Taller-de-sistemas-embebidos-tps/tdse-tf_2-01/Memoria_del_Trabajo_Final_Sleep_Centinel/img/diagrama_de_bloques.png

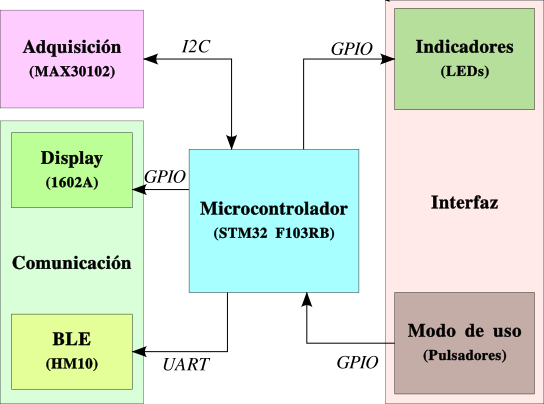
Memoria_del_Trabajo_Final_Sleep_Centinel/img/diagrama_de_bloques.png
