Taller-de-sistemas-embebidos-tps/tdse-tf_2-01/Memoria_del_Trabajo_Final_Sleep_Centinel/img/maqestadosystem.jpeg

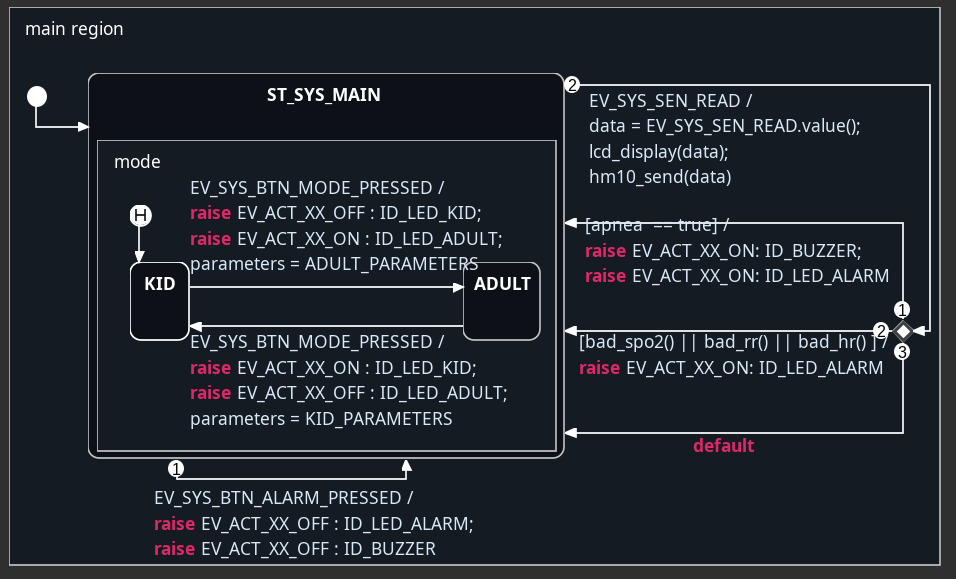
Memoria_del_Trabajo_Final_Sleep_Centinel/img/maqestadosystem.jpeg
