Taller-de-sistemas-embebidos-tps/tdse-tf_2-01/kicad/models/Part_04_varible_resister.stp

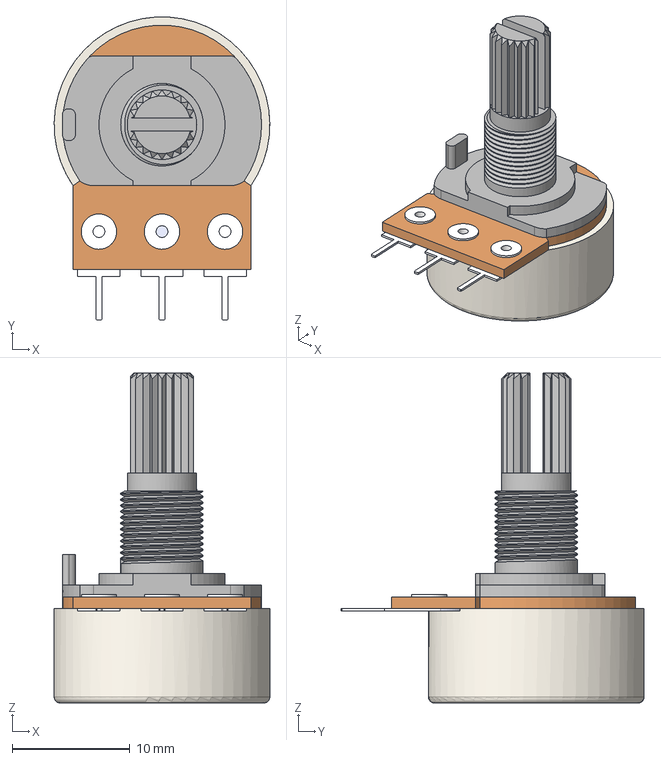
[picture p36: CAD file, 2026-03-10]
kicad/models/Part_04_varible_resister.stp
18.3 x 25.7 x 28.0 mm
