Taller-de-sistemas-embebidos-tps/tdse-tf_2-01/TODO.md

##
Una lista de puequeños TODOs para organizar el desarrollo
- [ ] Optimizar uso de format_string para que solo actualice los valores en lugar de todo el texto
- [ ] Formatear los datos a enviar por bluetooth
- [ ] Eliminar comentarios en el codigo
- [ ] Agregar lógica de transicion de finger in o out en task_sensor
