Taller-de-sistemas-embebidos-tps/tdse-tf_2-01/kicad/schematic.pdf

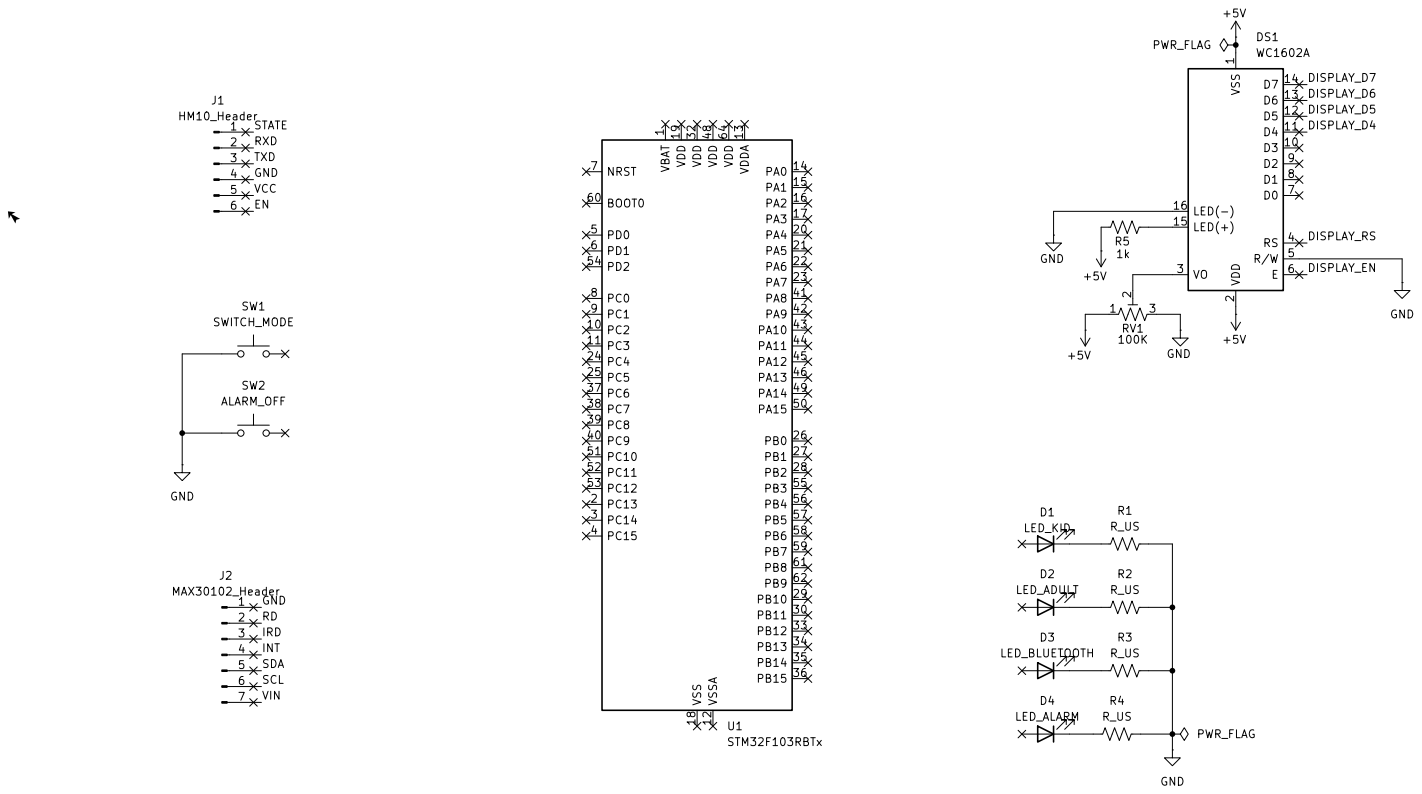
[picture p37: page 1]
