Taller-de-sistemas-embebidos-tps/tdse-tf_2-01/kicad/tp.kicad_pcb

## KiCad design kicad/tp.kicad_pcb (2026-03-10)

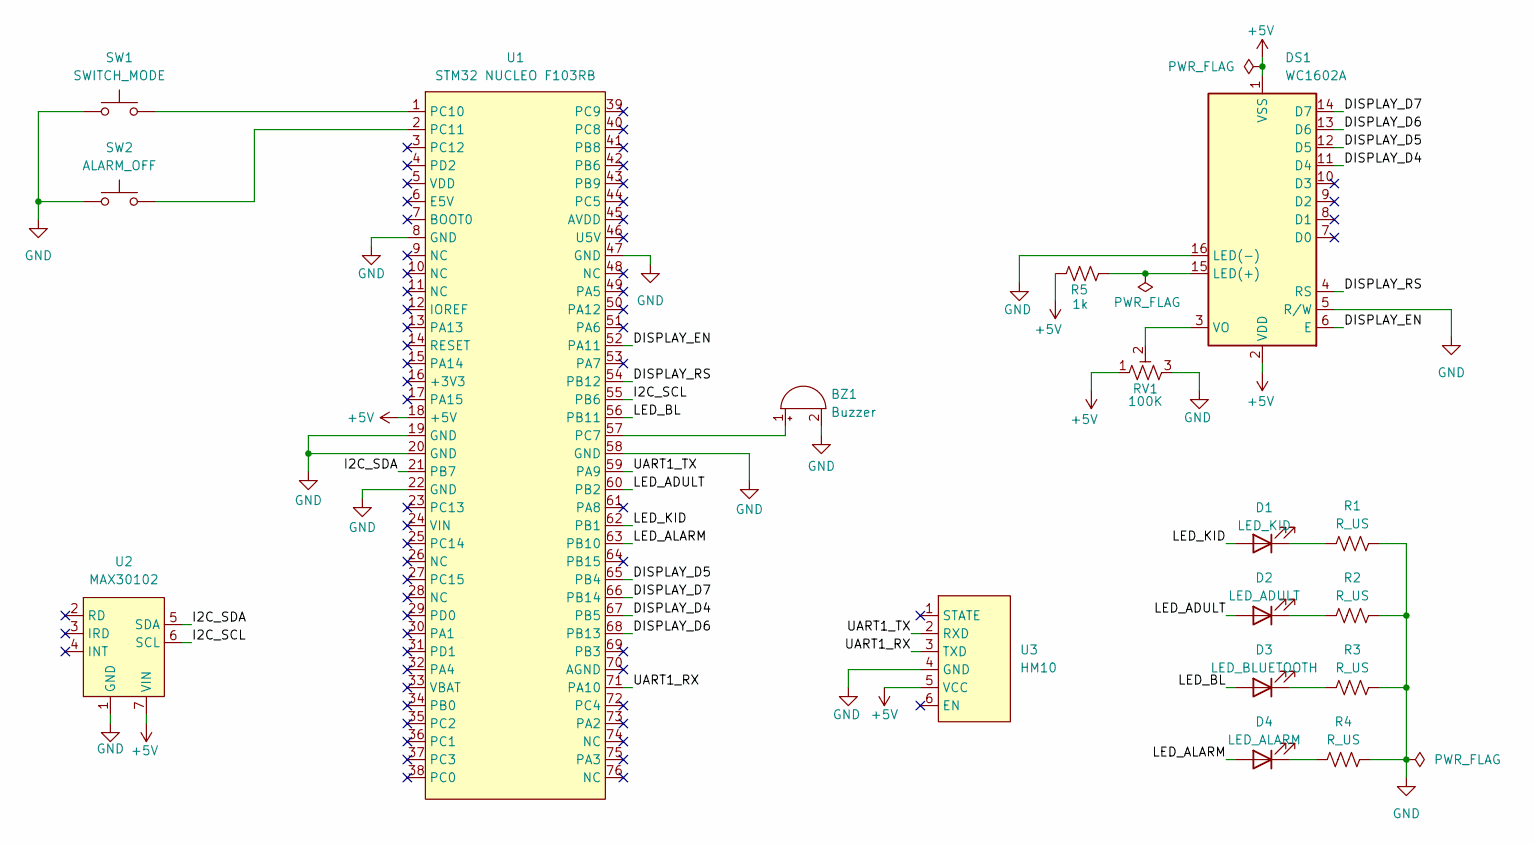
[picture p38: schematic tp.kicad_sch]

Parts:
BZ1: Buzzer; Buzzer_12x9.5RM7.6
D1: LED_KID; LED_D5.0mm
D2: LED_ADULT; LED_D5.0mm
D3: LED_BLUETOOTH; LED_D5.0mm
D4: LED_ALARM; LED_D5.0mm
DS1: WC1602A
R1, R2, R3, R4: R_US; R_Axial_DIN0207_L6.3mm_D2.5mm_P7.62mm_Horizontal
R5: 1k; R_Axial_DIN0207_L6.3mm_D2.5mm_P7.62mm_Horizontal
RV1: 100K; Potentiometer_Alps_RK163_Single_Horizontal
SW1: SWITCH_MODE; SW_PUSH-12mm_Wuerth-430476085716
SW2: ALARM_OFF; SW_PUSH-12mm_Wuerth-430476085716
U1: STM32 NUCLEO F103RB; NUCLEO F103RB
U2: MAX30102; PinSocket_1x07_P2.54mm_Vertical
U3: HM10; PinSocket_1x06_P2.54mm_Vertical

Connections:
+5V: DS1.1 (VSS), DS1.2 (VDD), R5.2, RV1.1, U1.18 (+5V), U2.7 (VIN), U3.5 (VCC)
/DISPLAY_D4: DS1.11 (D4), U1.67 (PB5)
/DISPLAY_D5: DS1.12 (D5), U1.65 (PB4)
/DISPLAY_D6: DS1.13 (D6), U1.68 (PB13)
/DISPLAY_D7: DS1.14 (D7), U1.66 (PB14)
/DISPLAY_EN: DS1.6 (E), U1.52 (PA11)
/DISPLAY_RS: DS1.4 (RS), U1.54 (PB12)
/I2C_SCL: U1.55 (PB6), U2.6 (SCL)
/I2C_SDA: U1.21 (PB7), U2.5 (SDA)
/LED_ADULT: D2.2 (A), U1.60 (PB2)
/LED_ALARM: D4.2 (A), U1.63 (PB10)
/LED_BL: D3.2 (A), U1.56 (PB11)
/LED_KID: D1.2 (A), U1.62 (PB1)
/UART1_RX: U1.71 (PA10), U3.3 (TXD)
/UART1_TX: U1.59 (PA9), U3.2 (RXD)
GND: BZ1.2 (-), DS1.5 (R/W), DS1.16 (LED(-)), R1.2, R2.2, R3.2, R4.2, RV1.3, SW1.1, SW2.1, U1.8 (GND), U1.19 (GND), U1.20 (GND), U1.22 (GND), U1.47 (GND), U1.58 (GND), U2.1 (GND), U3.4 (GND)
unnamed: BZ1.1 (+), U1.57 (PC7)
unnamed: D1.1 (K), R1.1
unnamed: D2.1 (K), R2.1
unnamed: D3.1 (K), R3.1
unnamed: D4.1 (K), R4.1
unnamed: DS1.15 (LED(+)), R5.1
unnamed: DS1.3 (VO), RV1.2
unnamed: SW1.2, U1.1 (PC10)
unnamed: SW2.2, U1.2 (PC11)

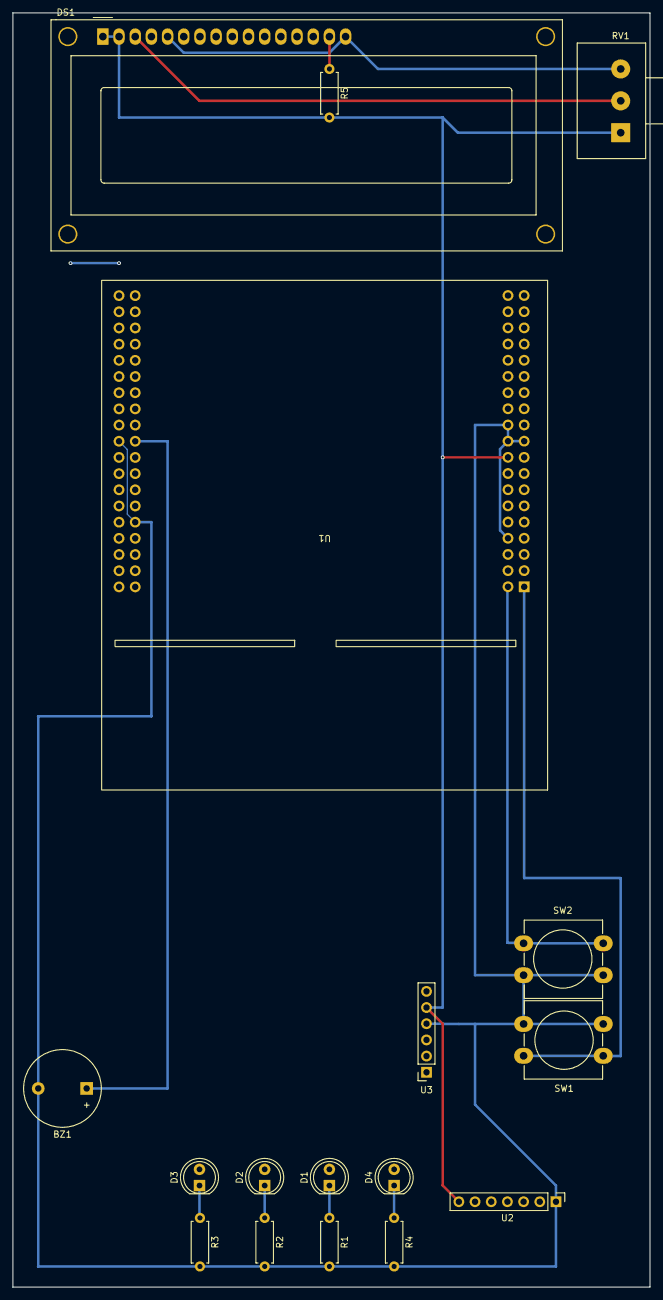
[picture p39: board tp.kicad_pcb from above]

Board: 10 copper layers, 100.0 x 200.0 mm, 17 parts (0 on the bottom side), 25 nets.
