Taller-de-sistemas-embebidos-tps/tdse-tf_2-01/code_final/Core/Inc/main.h

#define B1_Pin GPIO_PIN_13
#define B1_GPIO_Port GPIOC
#define B1_EXTI_IRQn EXTI15_10_IRQn
#define USART_TX_Pin GPIO_PIN_2
#define USART_TX_GPIO_Port GPIOA
#define USART_RX_Pin GPIO_PIN_3
#define USART_RX_GPIO_Port GPIOA
#define LD2_Pin GPIO_PIN_5
#define LD2_GPIO_Port GPIOA
#define LED_KID_Pin GPIO_PIN_1
#define LED_KID_GPIO_Port GPIOB
#define LED_ADULT_Pin GPIO_PIN_2
#define LED_ADULT_GPIO_Port GPIOB
#define LED_ALARM_Pin GPIO_PIN_10
#define LED_ALARM_GPIO_Port GPIOB
#define LED_BL_Pin GPIO_PIN_11
#define LED_BL_GPIO_Port GPIOB
#define DISPLAY_RS_Pin GPIO_PIN_12
#define DISPLAY_RS_GPIO_Port GPIOB
#define DISPLAY_D6_Pin GPIO_PIN_13
#define DISPLAY_D6_GPIO_Port GPIOB
#define DISPLAY_D7_Pin GPIO_PIN_14
#define DISPLAY_D7_GPIO_Port GPIOB
#define BUZZER_Pin GPIO_PIN_7
#define BUZZER_GPIO_Port GPIOC
#define DISPLAY_EN_Pin GPIO_PIN_11
#define DISPLAY_EN_GPIO_Port GPIOA
#define TMS_Pin GPIO_PIN_13
#define TMS_GPIO_Port GPIOA
#define TCK_Pin GPIO_PIN_14
#define TCK_GPIO_Port GPIOA
#define BTN_MODE_Pin GPIO_PIN_10
#define BTN_MODE_GPIO_Port GPIOC
#define BTN_ALARM_Pin GPIO_PIN_11
#define BTN_ALARM_GPIO_Port GPIOC
#define BTN_PAIRING_Pin GPIO_PIN_12
#define BTN_PAIRING_GPIO_Port GPIOC
#define SWO_Pin GPIO_PIN_3
#define SWO_GPIO_Port GPIOB
#define DISPLAY_D5_Pin GPIO_PIN_4
#define DISPLAY_D5_GPIO_Port GPIOB
#define DISPLAY_D4_Pin GPIO_PIN_5
#define DISPLAY_D4_GPIO_Port GPIOB
