Taller-de-sistemas-embebidos-tps/tdse-tf_2-01/code_final/app/src/task_system.c

/*
 * Copyright (c) 2023 Juan Manuel Cruz <jcruz@fi.uba.ar> <jcruz@frba.utn.edu.ar>.
 * All rights reserved.
 *
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
 * 1. Redistributions of source code must retain the above copyright
 *    notice, this list of conditions and the following disclaimer.
 *
 * 2. Redistributions in binary form must reproduce the above copyright
 *    notice, this list of conditions and the following disclaimer in the
 *    documentation and/or other materials provided with the distribution.
 *
 * 3. Neither the name of the copyright holder nor the names of its
 *    contributors may be used to endorse or promote products derived from
 *    this software without specific prior written permission.
 *
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
 * @file   : task_system.c
 * @date   : Set 26, 2023
 * @author : Juan Manuel Cruz <jcruz@fi.uba.ar> <jcruz@frba.utn.edu.ar>
 * @version	v1.0.0
 */

/********************** inclusions *******************************************/
/* Project includes */
#include "main.h"

/* Demo includes */
#include "logger.h"
#include "dwt.h"

/* Application & Tasks includes */
#include "board.h"
#include "app.h"
#include "task_system_attribute.h"
#include "task_system_interface.h"
#include "task_actuator_attribute.h"
#include "task_actuator_interface.h"
#include "display.h"
#include "comm.h"

extern UART_HandleTypeDef huart2;

/********************** macros and definitions *******************************/
#define G_TASK_SYS_CNT_INI			0ul
#define G_TASK_SYS_TICK_CNT_INI		0ul

#define DEL_SYS_MIN					0ul
#define DEL_SYS_MED					25ul
#define DEL_SYS_MAX					50ul

#define SPO2_LOW				86

#define HR_LOW_KID_THRESHOLD	90
#define HR_HIGH_KID_THRESHOLD	120
#define RR_LOW_KID_THRESHOLD	15
#define RR_HIGH_KID_THRESHOLD	30

#define HR_LOW_ADULT_THRESHOLD	45
#define HR_HIGH_ADULT_THRESHOLD	90
#define RR_LOW_ADULT_THRESHOLD	10
#define RR_HIGH_ADULT_THRESHOLD	20

/********************** internal data declaration ****************************/
const parameters_t kid_parameters  = {
	.spo2 = SPO2_LOW,
	.min_hr = HR_LOW_KID_THRESHOLD,
	.max_hr = HR_HIGH_KID_THRESHOLD,
	.min_rr = RR_LOW_KID_THRESHOLD,
	.max_rr = RR_HIGH_KID_THRESHOLD,
};

const parameters_t adult_parameters = {
	.spo2 = SPO2_LOW,
	.min_hr = HR_LOW_ADULT_THRESHOLD,
	.max_hr = HR_HIGH_ADULT_THRESHOLD,
	.min_rr = RR_LOW_ADULT_THRESHOLD,
	.max_rr = RR_HIGH_ADULT_THRESHOLD,
};

task_system_dta_t task_system_dta =	{
	.state = ST_SYS_MAIN,
	.event = EV_SYS_BTN_PAIRING_PRESSED,
	.mode = ID_KID,
	.tick = DEL_SYS_MAX,
	.parameters = kid_parameters
};

/********************** internal functions declaration ***********************/
void task_system_statechart(void);

void format_to_lcd_string(char out[2][17], task_sensor_results_dta_t data);

void print_to_lcd(char formatted_data[2][17]);

/********************** internal data definition *****************************/
const char *p_task_system 		= "Task System (System Statechart)";
const char *p_task_system_ 		= "Non-Blocking & Update By Time Code";

/********************** external data declaration ****************************/
uint32_t g_task_system_cnt;
volatile uint32_t g_task_system_tick_cnt;

/********************** external functions definition ************************/
void task_system_init(void *parameters)
{
	task_system_dta_t 	*p_task_system_dta;
	task_system_st_t	state;

	/* Print out: Task Initialized */
	//LOGGER_INFO(" ");
	//LOGGER_INFO("  %s is running - %s", GET_NAME(task_system_init), p_task_system);
	//LOGGER_INFO("  %s is a %s", GET_NAME(task_system), p_task_system_);

	/* Init & Print out: Task execution counter */
	g_task_system_cnt = G_TASK_SYS_CNT_INI;
	//LOGGER_INFO("   %s = %lu", GET_NAME(g_task_system_cnt), g_task_system_cnt);

	init_queue_event_task_system();

	/* Update Task Actuator Configuration & Data Pointer */
	p_task_system_dta = &task_system_dta;

	/* Init & Print out: Task execution FSM */
	state = ST_SYS_MAIN;
	p_task_system_dta->state = state;

	//LOGGER_INFO(" ");
	//LOGGER_INFO("   %s = %lu   %s = %lu   %s = %s",
	//			 GET_NAME(state), (uint32_t)state,
	//			 GET_NAME(event), (uint32_t)event,
	//			 GET_NAME(b_event), (b_event ? "true" : "false"));

	displayInit( DISPLAY_CONNECTION_GPIO_4BITS );

    displayCharPositionWrite(0, 0);
	displayStringWrite("Sleep Centinel");

	hm10_init(&huart2);
}

void task_system_update(void *parameters)
{
	bool b_time_update_required = false;

	/* Protect shared resource */
	__asm("CPSID i");	/* disable interrupts */
    if (G_TASK_SYS_TICK_CNT_INI < g_task_system_tick_cnt)
    {
		/* Update Tick Counter */
    	g_task_system_tick_cnt--;
    	b_time_update_required = true;
    }
    __asm("CPSIE i");	/* enable interrupts */

    while (b_time_update_required)
    {
		/* Update Task Counter */
		g_task_system_cnt++;

		/* Run Task Statechart */
    	task_system_statechart();

    	/* Protect shared resource */
		__asm("CPSID i");	/* disable interrupts */
		if (G_TASK_SYS_TICK_CNT_INI < g_task_system_tick_cnt)
		{
			/* Update Tick Counter */
			g_task_system_tick_cnt--;
			b_time_update_required = true;
		}
		else
		{
			b_time_update_required = false;
		}
		__asm("CPSIE i");	/* enable interrupts */
    }
}

void task_system_statechart(void)
{
	task_system_dta_t *p_task_system_dta;

	p_task_system_dta = &task_system_dta;


	if (true == any_event_task_system())
	{
		p_task_system_dta->event = get_event_task_system();


		switch (p_task_system_dta->state)
		{
			case ST_SYS_MAIN:
				switch (p_task_system_dta->event) {
					case EV_SYS_BTN_MODE_PRESSED:
						//LOGGER_INFO("cambiando de estado");
						if (p_task_system_dta->mode == ID_KID) {
							p_task_system_dta->mode = ID_ADULT;
							p_task_system_dta->parameters = adult_parameters;
							put_event_task_actuator(EV_ACT_OFF, ID_LED_KID);
							put_event_task_actuator(EV_ACT_ON, ID_LED_ADULT);
							displayCharPositionWrite(0, 1);
							displayStringWrite("           ");
							displayCharPositionWrite(0, 1);
							displayStringWrite("Modo adulto");
						} else {
							p_task_system_dta->mode = ID_KID;
							p_task_system_dta->parameters = kid_parameters;
							put_event_task_actuator(EV_ACT_OFF, ID_LED_ADULT);
							put_event_task_actuator(EV_ACT_ON, ID_LED_KID);
							displayCharPositionWrite(0, 1);
							displayStringWrite("           ");
							displayCharPositionWrite(0, 1);
							displayStringWrite("Modo nino");
						}
						break;

					case EV_SYS_BTN_ALARM_PRESSED:
						put_event_task_actuator(EV_ACT_OFF, ID_LED_ALARM);
						put_event_task_actuator(EV_ACT_OFF, ID_BUZZER);
						//LOGGER_INFO("Apagando la alarma");
						break;

					case EV_SYS_BTN_PAIRING_PRESSED:
						put_event_task_actuator(EV_ACT_BLINK, ID_LED_BLUETOOTH);
						break;

					case EV_SYS_SEN_READ:
						static char lcd_text[2][17];

						task_sensor_results_dta_t result = get_sensor_results();
						format_to_lcd_string(lcd_text, result);
						print_to_lcd(lcd_text);
						hm10_send_data((uint8_t *)lcd_text, 17*2);

						parameters_t params = p_task_system_dta->parameters;
						if (
							result.spo2 < params.spo2 ||
							result.heart_rate < params.min_hr || result.heart_rate > params.max_hr ||
							result.respiratory_rate < params.min_rr || result.respiratory_rate > params.max_rr
						) {
							put_event_task_actuator(EV_ACT_ON, ID_LED_ALARM);
						}

						if (result.apnea == true) {
							put_event_task_actuator(EV_ACT_ON, ID_LED_ALARM);
							put_event_task_actuator(EV_ACT_ON, ID_BUZZER);
						}
						break;

					default:
						break;
				}

				break;

			default:
				p_task_system_dta->state = ST_SYS_MAIN;
				// p_task_system_dta->event = EV_SYS_IDLE;
				break;
		}
	}
}

void format_to_lcd_string(char out[2][17], task_sensor_results_dta_t data)
{
    // Línea 1
    out[0][0] = 'a';
    out[0][1] = 'p';
    out[0][2] = 'n';
    out[0][3] = 'e';
    out[0][4] = 'a';
    out[0][5] = ' ';

    if(data.apnea) {
        out[0][6] = 'S';
        out[0][7] = 'I';
    } else {
        out[0][6] = 'N';
        out[0][7] = 'O';
    }

    out[0][8]  = ' ';
    out[0][9]  = ' ';
    out[0][10] = 'h';
    out[0][11] = 'r';
    out[0][12] = ' ';

    out[0][13] = '0' + (data.heart_rate / 100) % 10;
    out[0][14] = '0' + (data.heart_rate / 10) % 10;
    out[0][15] = '0' + (data.heart_rate % 10);

    out[0][16] = '\0';

    // Línea 2
    out[1][0] = 's';
    out[1][1] = 'p';
    out[1][2] = 'o';
    out[1][3] = '2';
    out[1][4] = ' ';

    out[1][5] = '0' + (data.spo2 / 100) % 10;
    out[1][6] = '0' + (data.spo2 / 10) % 10;
    out[1][7] = '0' + (data.spo2 % 10);

    out[1][8]  = ' ';
    out[1][9]  = ' ';
    out[1][10] = 'r';
    out[1][11] = 'r';
    out[1][12] = ' ';

    out[1][13] = '0' + (data.respiratory_rate / 100) % 10;
    out[1][14] = '0' + (data.respiratory_rate / 10) % 10;
    out[1][15] = '0' + (data.respiratory_rate % 10);

    out[1][16] = '\0';
}

void print_to_lcd(char formatted_data[2][17]) {
	displayCharPositionWrite(0, 0);
	displayStringWrite(formatted_data[0]);
	displayCharPositionWrite(0, 1);
	displayStringWrite(formatted_data[1]);
}

/********************** end of file ******************************************/
