Taller-de-sistemas-embebidos-tps/tdse-tf_2-01/(commit log)

2025-11-14 docs: Agrego periodo de entrega
2025-11-15 Adjunto diagrame de bloques
2025-11-15 docs: Arreglo URL del diagrama de bloques
2025-11-15 docs: Corrijo modelo de placa
2025-11-15 Correcion de imagenes y redaccón
2025-11-19 Limpio el repositorio
2025-11-19 docs: agrego la descripción del proyecto
2026-02-01 feat: agrega codigo base de proyecto
2026-02-02 feat: agrega botones de interaccion
2026-02-02 fix: comento pines no usados y arreglo las cfg de los botones
    [display.c, task_sensor.c]
2026-02-05 Create Informe de avance
2026-02-05 docs: agrega bullet de alimentacion
2026-02-25 feat: agrega pines del display
    [code Debug.cfg]
2026-02-25 feat: descomenta uso de pines para display
2026-02-25 fix: typo y agrega boton de pairing
    [main.c, main.h]
2026-02-25 feat: agrega esqueleto de tarea de comunicacion
2026-02-25 feat(comm): agrega estructuras de cfg y dta pertinentes
2026-02-25 refactor: comenta temporalmente la communicacion
    hasta saber bien como inicializar uart
2026-02-25 feat(actuator): actualiza cfg y dta por modelo real de un led/buzzer
    [task_actuator.c, task_actuator_attribute.h]
2026-02-25 feat: agrega parámetro de futura optimización
2026-02-25 feat: actualiza interfaz para interactuar con el actuador
2026-02-25 feat(button): agrega config pull_up de pines
2026-02-25 feat: agrega version de proyecto funcional
    el otro no corre los ticks y no sabemos por qué
    [code_final.cfg]
2026-02-25 feat(button): cambio de pines a los nuestros
2026-02-25 feat(actuator): agrega pines y attributos
2026-02-26 feat(system): solo ejecuta el statechart si hay eventos
2026-02-26 fix(actuator): agrega parametros de modo
    [task_actuator.c, task_system_attribute.h]
2026-02-26 feat(actuator): agrega blink_funcional
2026-02-26 feat(system): se postea el evento blink al led bluetooth
2026-02-26 feat(button): el boton de pairing sera reemplazado por pin STATE
2026-02-26 feat(system): agrega posteo de info al hm10
    TODO: checkear si el pin STATE esta en ON
2026-02-27 feat(sch): agrega esquematico inicial con leds
    [tp.kicad_pcb, tp.kicad_sch]
2026-02-27 feat(sch): agrega botones
    [tp.kicad_sch]
2026-02-27 fix(sch): agrega flag de power para ERC
    [tp.kicad_sch]
2026-02-27 feat(sch): agrega display lcd
    [tp.kicad_sch]
2026-02-27 feat(sch): agrega pines del hm10
    [tp.kicad_sch]
2026-02-27 feat(sch): agrega pines del max30102
    [tp.kicad_sch]
2026-02-27 style(sch): acomoda ubicaciones en la hoja
    [tp.kicad_sch]
2026-03-04 feat(system): el systema envia datos por uart al modulo
2026-03-04 Agregando la carpeta del sensor al repositorio
    [sensor Debug.cfg]
2026-03-04 refactor(button): cambio de nombre sensor por boton
    el sensor es el max30102 no los botones
2026-03-04 feat(sensor): habilita I2C en el .ioc
2026-03-04 feat(sensor): agrega funciones para leer el max30102 y procesar sus datos
2026-03-04 Agrego procesamiento de la señal max30102
2026-03-05 feat(sensor): agrega esqueleto de task para el sensor
2026-03-05 feat(sensor): el sensor postea al sistema datos (dummy) cada x ticks
2026-03-05 feat(system): recibe data del sensor y la postea cuando es nueva
2026-03-05 feat(system): agrega funcion para formatear sensor data a lcd 16x2
2026-03-05 chore: elimino proyecto anterior
    [code Debug.cfg]
2026-03-05 chore: agrega lista de pequeños TODOs que van surgiendo
2026-03-05 feat(sch): agrega symbol, footprint, y model de la NUCLEO-F103RB
    [tp.kicad_sch]
2026-03-05 fix(sch): actualizo campos del symbol de la nucleo
    [tp.kicad_sch]
2026-03-05 feat(sensor): agrega lectura del sensor cada 100 ticks
    si se cambia ticks a mas de 200 empieza a fallar
    no entra a los otros tasks
2026-03-05 fix(sch): elimino error de ERC en el symbol de nucleo
    [tp.kicad_sch]
2026-03-05 feat(sensor): el sensor solo mide si detecta un dedo
    crear estados intermedios para confirmar dedo dentro o fuera (simil
    debouncing)
2026-03-05 feat(system): el sistema prende la alarma si detecta baja spo2
2026-03-05 Agrego logica de umbrales en sistema
    [code_final Debug.cfg]
2026-03-05 Correciones de texto.
2026-03-05 Correción de logica de control.
2026-03-05 feat(sch): agrego symbol del hm10
    [tp.kicad_sch]
2026-03-06 feat(system): agrega logica de seteo de parametros en el task_system
    para setear los parametros segun el id
2026-03-06 fix(system): inicializa los parametros del system
    [task_system.c]
2026-03-06 feat(sch): agrega symbols y conexiones faltantes
    [tp.kicad_sch]
2026-03-06 fix(sch): actualizo el simbolo de la nucleo
    [tp.kicad_sch]
2026-03-06 fix(system): los parametros son constantes
    [task_system.c, task_system_attribute.h]
2026-03-06 feat(sch): agrego las footprints de los componentes
    [tp.kicad_sch]
2026-03-06 feat(sch): agrega symbol custom del max30102
    [tp.kicad_sch]
2026-03-06 fix(sch): el symbol tenia asociada una huella incorrecta
    [tp.kicad_sch]
2026-03-06 fix(sch): actualiza symbol del max30102
    [tp.kicad_sch]
2026-03-06 style(sch): cambio el footprint por un pinsocket
    [tp.kicad_sch]
2026-03-06 feat(sch): agrego pcb de laa perfboard
    [tp.kicad_pcb]
2026-03-06 feat(sch): agrego agujeritos de perfboard en preview 3D
    [tp.kicad_pcb]
2026-03-08 feat(pcb): agrego modelo para el potenciómetro
    la footprint del potenciometro parece ser un poco mas pequeña que el
    modelo. O tal vez el modelo es muy grande(?
    comprobar con calibre
    [Part_04_varible_resister.stp, tp.kicad_pcb]
2026-03-08 feat(pcb): agrego script para exportar svg
2026-03-10 feat(kicad): agrego script para exportar svg y renders 3D
2026-03-10 Alternativa mas precisa para detectar apneas
2026-03-14 Elimino carpeta sensor de prueba
    [sensor Debug.cfg]
2026-03-14 feat: informe en latex
    lleno de archivos basura
    agregarlos al .gitignore
2026-03-16 Factor de uso y consumo
2026-03-16 Agrego capturas de console y compile
2026-03-16 Ajusto parametros del sensor
2026-03-17 Agrego un unico punto que me faltaba
2026-03-17 Agrego indice de ecuaciones
2026-03-19 Correción de la primer entrega
2026-03-19 refactor(system): los datos ppg se reciben a través de un evento
2026-03-19 refactor(actuator): elimino warnings
    si se entra en el case default se espera que el evento cambie y no se
    hace ningun cambio
2026-03-19 refactor(actuator): elimino pulse y variables no usadas
2026-03-21 Correciones luego de 2da entrega
