Taller-de-sistemas-embebidos-tps/tdse-tf_2-01/(notices)

Notices in the files:
code_final/Core/Inc/main.h:
Copyright (c) 2025 STMicroelectronics.
All rights reserved.
This software is licensed under terms that can be found in the LICENSE file
